ThePurox/zplitzalp/zplitzalp.kicad_sch

## KiCad design zplitzalp.kicad_sch (2024-11-22)

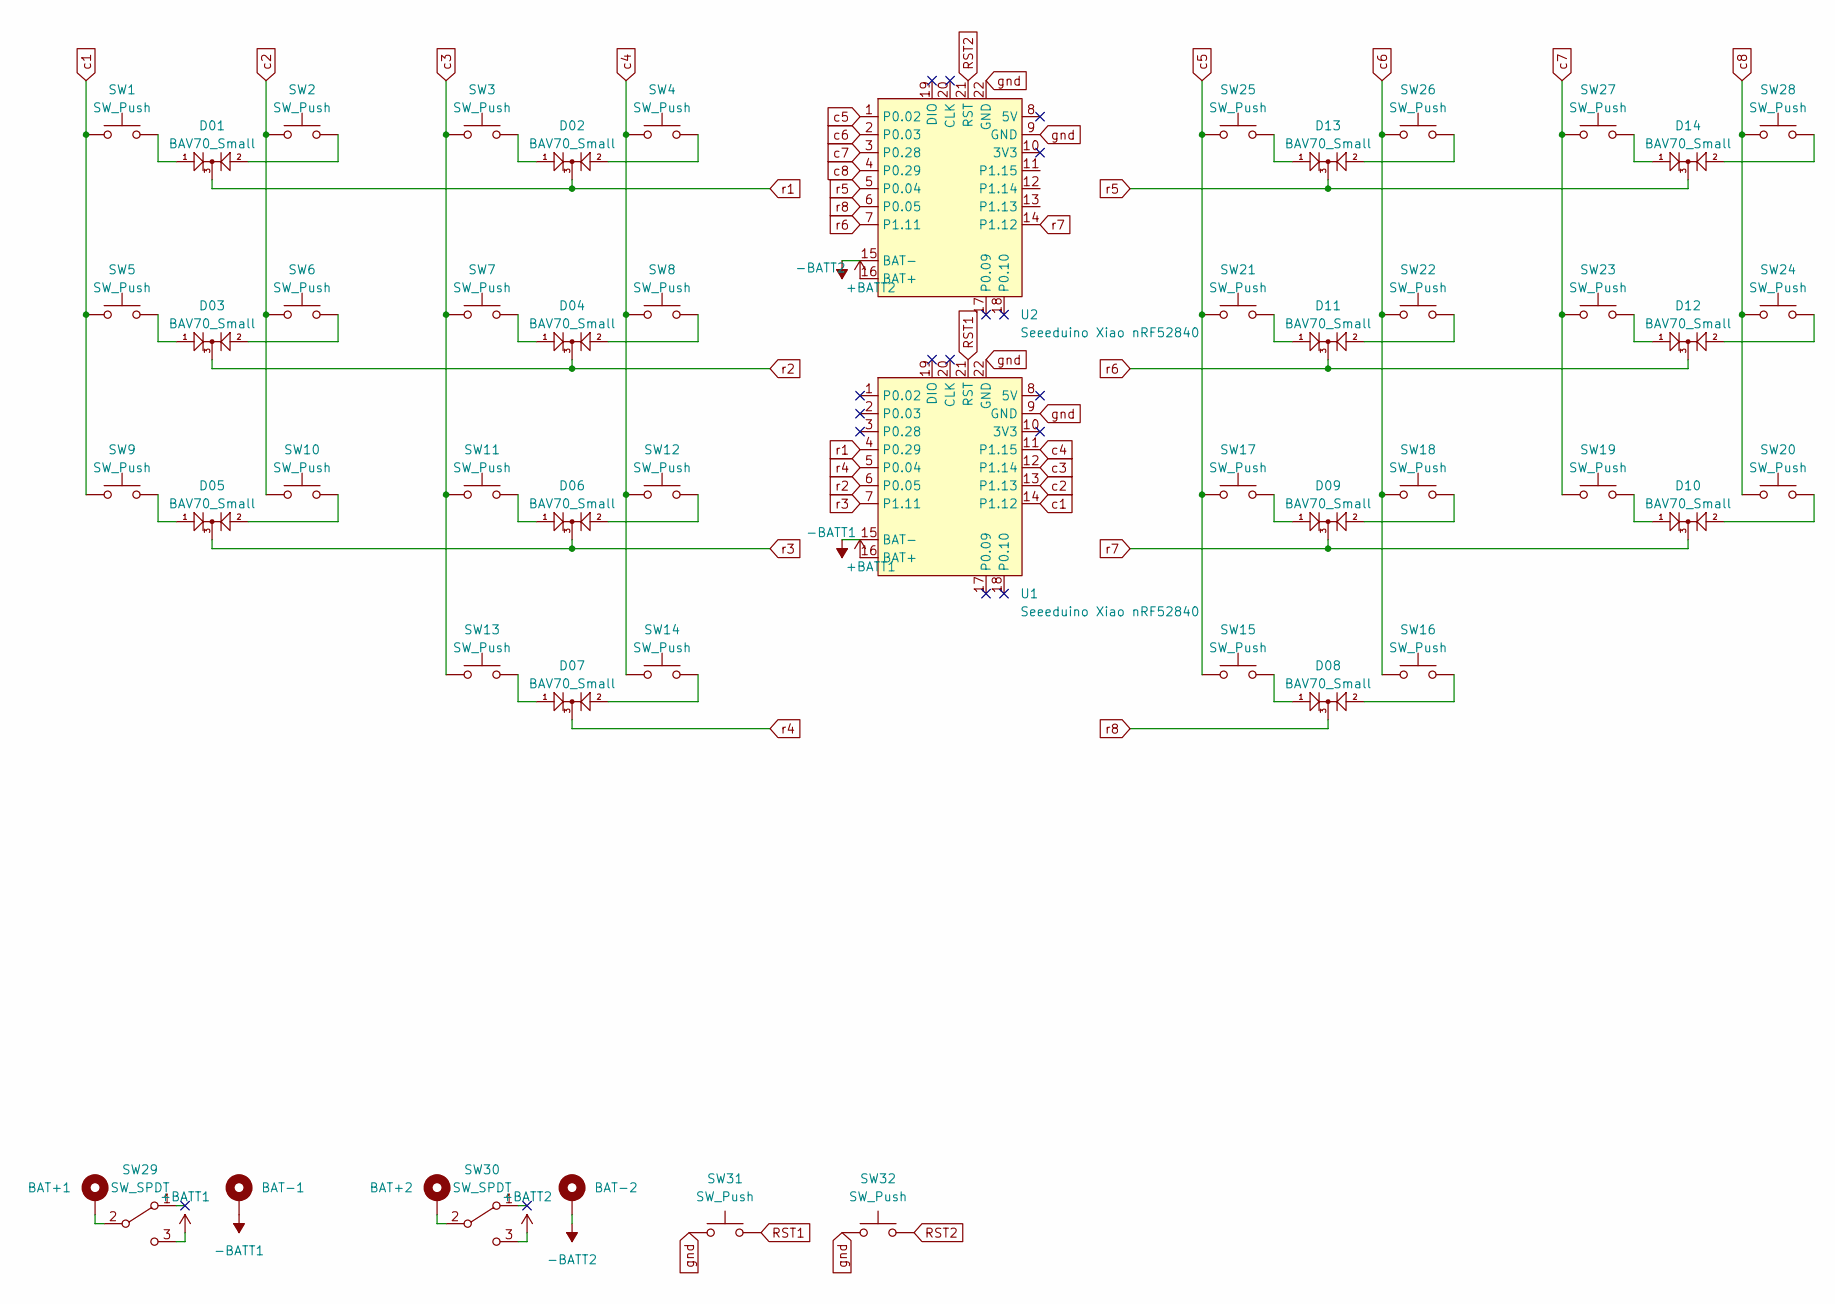
[picture p2: schematic zplitzalp.kicad_sch]

Parts:
BAT+1, BAT+2: +; BatteryPad
BAT-1, BAT-2: -; BatteryPad
D01, D02, D03, D04, D05, D06, D07, D08, D09, D10, D11, D12, D13, D14: BAV70_Small; SOT-23_Handsoldering
SW1, SW2, SW3, SW4, SW5, SW6, SW7, SW8, SW9, SW10, SW11, SW12, SW13, SW14, SW15, SW16, SW17, SW18, SW19, SW20, SW21, SW22, SW23, SW24, SW25, SW26, SW27, SW28: SW_Push; Cherry_ULP_TH_CUT
SW29, SW30: SW_SPDT; MSK12C02
SW31, SW32: SW_Push; PushSwitch
U1, U2: Seeeduino Xiao nRF52840; xiao-ble-smd-cutout-extra-pins

Connections:
+BATT1: SW29.3 (C), U1.16 (BAT+)
+BATT2: SW30.3 (C), U2.16 (BAT+)
-BATT1: BAT-1.1, U1.15 (BAT-)
-BATT2: BAT-2.1, U2.15 (BAT-)
unnamed: BAT+1.1, SW29.2 (B)
unnamed: BAT+2.1, SW30.2 (B)
unnamed: D01.1 (A1), SW1.2
unnamed: D01.2 (A2), SW2.2
unnamed: D02.1 (A1), SW3.2
unnamed: D02.2 (A2), SW4.2
unnamed: D03.1 (A1), SW5.2
unnamed: D03.2 (A2), SW6.2
unnamed: D04.1 (A1), SW7.2
unnamed: D04.2 (A2), SW8.2
unnamed: D05.1 (A1), SW9.2
unnamed: D05.2 (A2), SW10.2
unnamed: D06.1 (A1), SW11.2
unnamed: D06.2 (A2), SW12.2
unnamed: D07.1 (A1), SW13.2
unnamed: D07.2 (A2), SW14.2
unnamed: D08.1 (A1), SW15.2
unnamed: D08.2 (A2), SW16.2
unnamed: D09.1 (A1), SW17.2
unnamed: D09.2 (A2), SW18.2
unnamed: D10.1 (A1), SW19.2
unnamed: D10.2 (A2), SW20.2
unnamed: D11.1 (A1), SW21.2
unnamed: D11.2 (A2), SW22.2
unnamed: D12.1 (A1), SW23.2
unnamed: D12.2 (A2), SW24.2
unnamed: D13.1 (A1), SW25.2
unnamed: D13.2 (A2), SW26.2
unnamed: D14.1 (A1), SW27.2
unnamed: D14.2 (A2), SW28.2
RST1: SW31.2, U1.21 (RST)
RST2: SW32.2, U2.21 (RST)
c1: SW1.1, SW5.1, SW9.1, U1.14 (P1.12)
c2: SW2.1, SW6.1, SW10.1, U1.13 (P1.13)
c3: SW3.1, SW7.1, SW11.1, SW13.1, U1.12 (P1.14)
c4: SW4.1, SW8.1, SW12.1, SW14.1, U1.11 (P1.15)
c5: SW15.1, SW17.1, SW21.1, SW25.1, U2.1 (P0.02)
c6: SW16.1, SW18.1, SW22.1, SW26.1, U2.2 (P0.03)
c7: SW19.1, SW23.1, SW27.1, U2.3 (P0.28)
c8: SW20.1, SW24.1, SW28.1, U2.4 (P0.29)
gnd: SW31.1, SW32.1, U1.9 (GND), U1.22 (GND), U2.9 (GND), U2.22 (GND)
r1: D01.3 (K), D02.3 (K), U1.4 (P0.29)
r2: D03.3 (K), D04.3 (K), U1.6 (P0.05)
r3: D05.3 (K), D06.3 (K), U1.7 (P1.11)
r4: D07.3 (K), U1.5 (P0.04)
r5: D13.3 (K), D14.3 (K), U2.5 (P0.04)
r6: D11.3 (K), D12.3 (K), U2.7 (P1.11)
r7: D09.3 (K), D10.3 (K), U2.14 (P1.12)
r8: D08.3 (K), U2.6 (P0.05)
